Siddharth1798/StmPong/PCB Files/PCB 3D.png

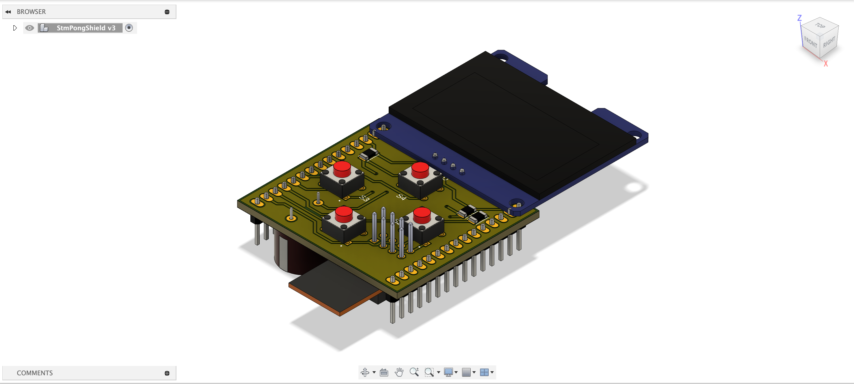
PCB Files/PCB 3D.png
