Siddharth1798/StmPong/PCB Files/Schematic.png

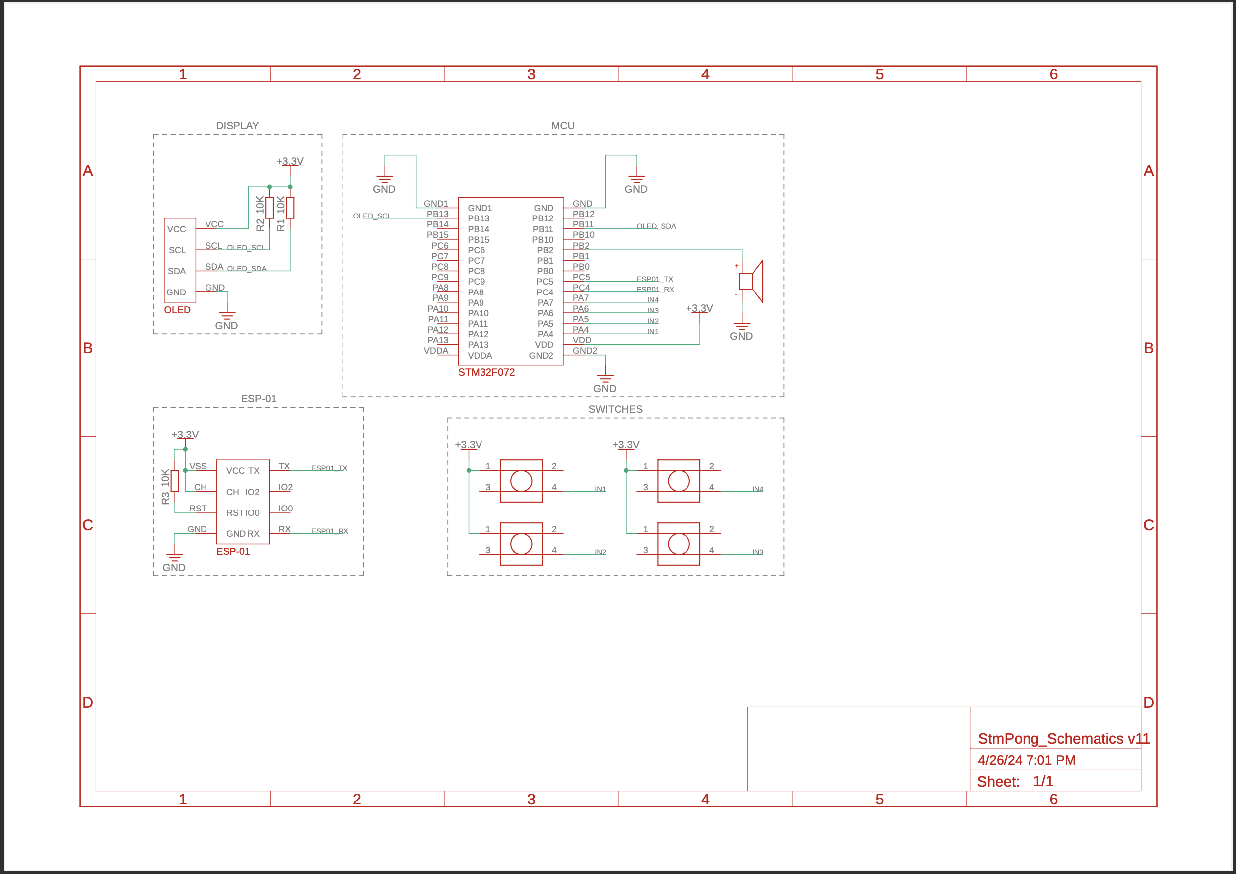
PCB Files/Schematic.png
