Siddharth1798/StmPong/PCB Files/StmPong_Schematics v11.pdf

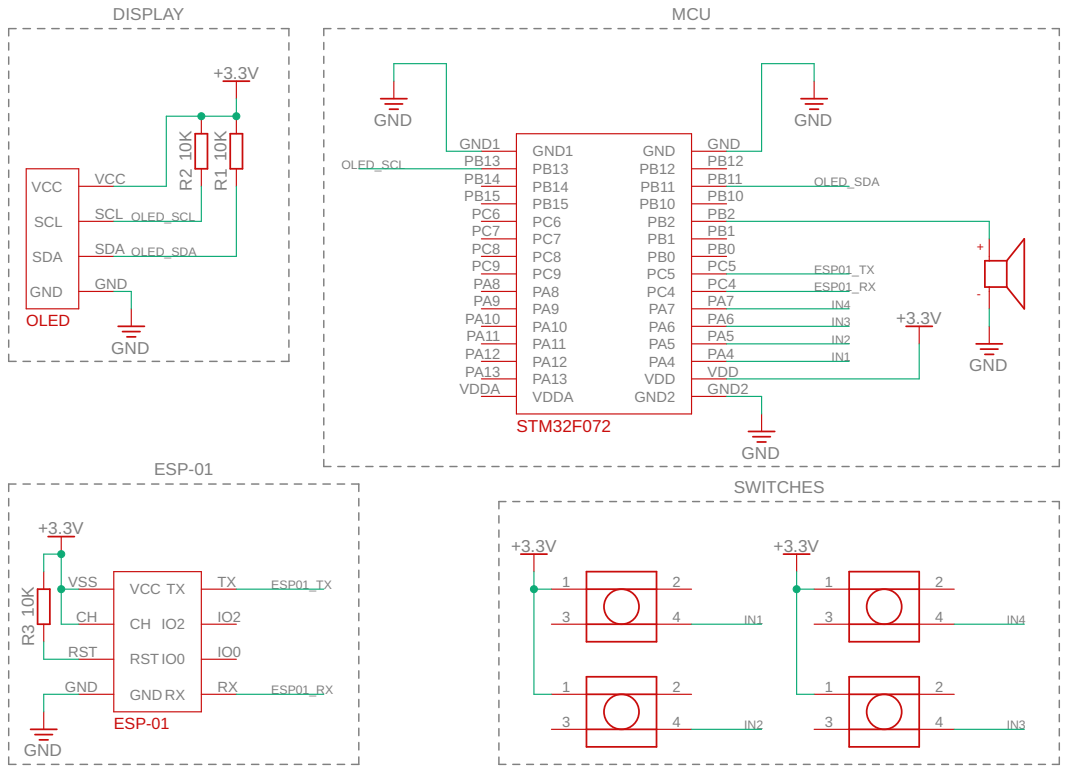
[picture p10: page 1]
