Siddharth1798/StmPong/PCB Files/StmPongShield v12.pdf

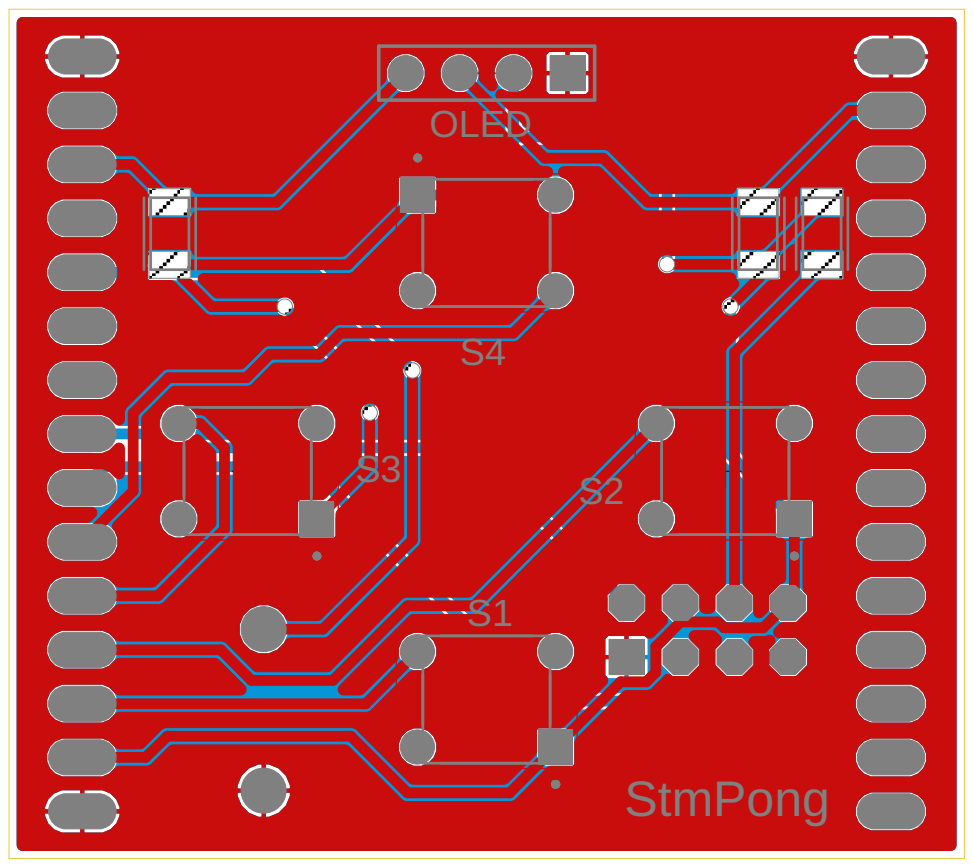
[picture p11: page 1]
