Siddharth1798/StmPong/Stmpong/Core/Src/gpio.c

#include "gpio.h"

void initLEDs(void) {	
	
	GPIOC->MODER |= ((1 << 12)|(1 << 14) | (1 << 16) | (1 << 18));
	GPIOC->MODER &= ~((1 << 13)|(1 << 15) | (1 << 17) | (1 << 19));
	
	GPIOC->OTYPER &= ~((1 << 6)|(1 << 7) | (1 << 8) | (1 << 9));
	
	GPIOC->OSPEEDR &= ~((1 << 12)|(1 << 14)|(1 << 16)|(1 << 18 ));
	
	GPIOC->PUPDR &= ~((1 << 13)|(1 << 15)|(1 << 12)|(1 << 14)|(1 << 16) | (1 << 18)|(1 << 17) | (1 << 19));
	
	GPIOC->ODR &= ~((1<<6)|(1<<7)|(1<<8)|(1<<9));

}
