Siddharth1798/StmPong/(commit log)

2024-03-25 Project Folder Added With Initial Files for Driver
2024-03-25 I2c Init function
2024-04-24 Revert "USART init"
    This reverts commit 731f4650a240307440e0283cfcf6975c705e63c4.
    [uart.c]
2024-04-24 Revert "Added USART peripheral"
    This reverts commit fcea4efa7ac196d0920ad355cf2928831b26481a.
    [uart.c]
2024-04-27 Added PCB Files
